JohnDSutter/Analog-Power-Meter-Rev-1/pics/pcb_assembled.jpg

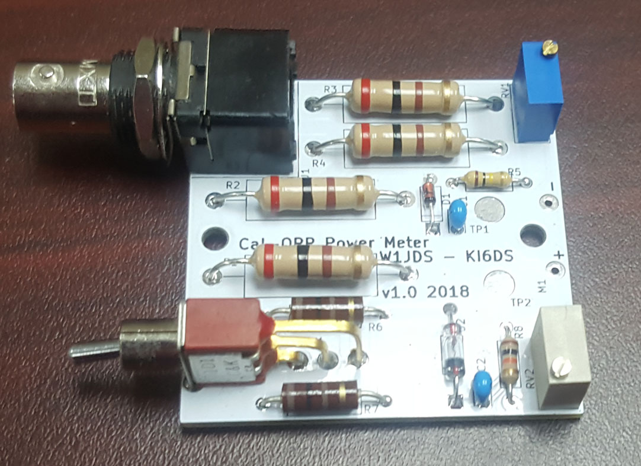
pics/pcb_assembled.jpg
