JohnDSutter/Analog-Power-Meter-Rev-1/pics/20180804_172026.jpg

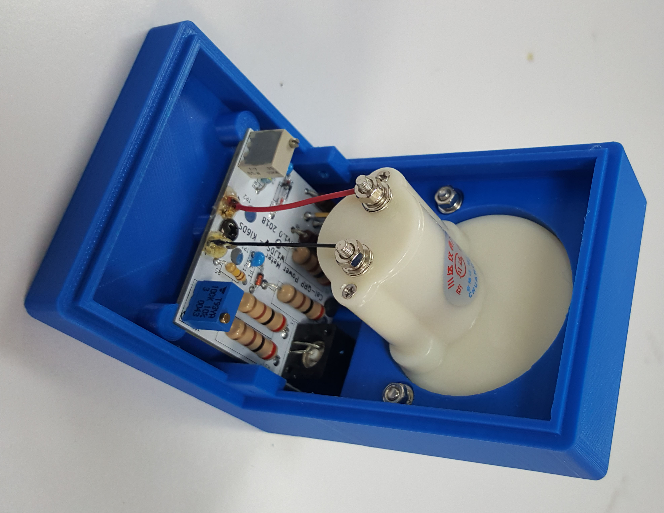
pics/20180804_172026.jpg
