JohnDSutter/Analog-Power-Meter-Rev-1/README.md

# Analog Power Meter Rev 1
 Analog RF Power Meter Designed as a CalQRP Club Project
