JohnDSutter/Analog-Power-Meter-Rev-1/meter face/scan_0064.pdf

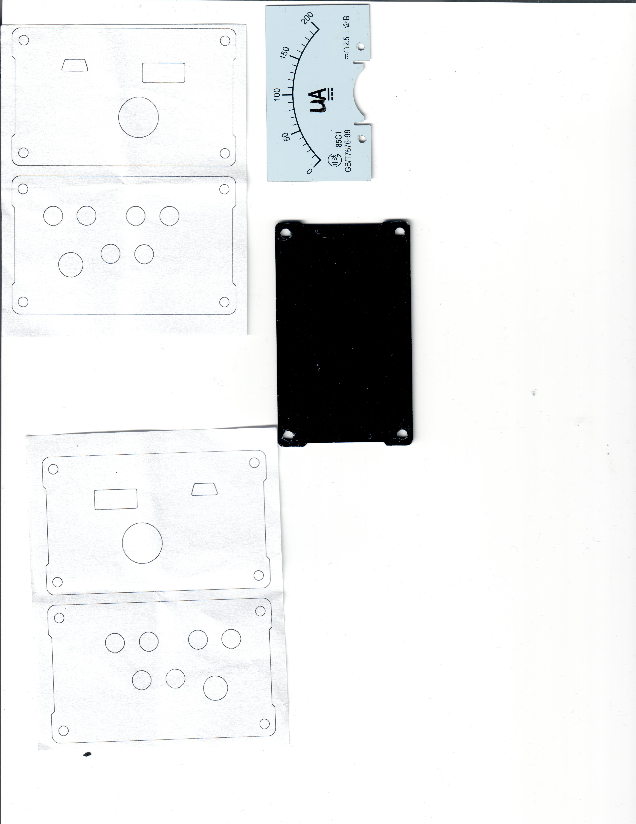
[picture p3: page 1]
