JohnDSutter/Analog-Power-Meter-Rev-1/Case/meter/001.JPG

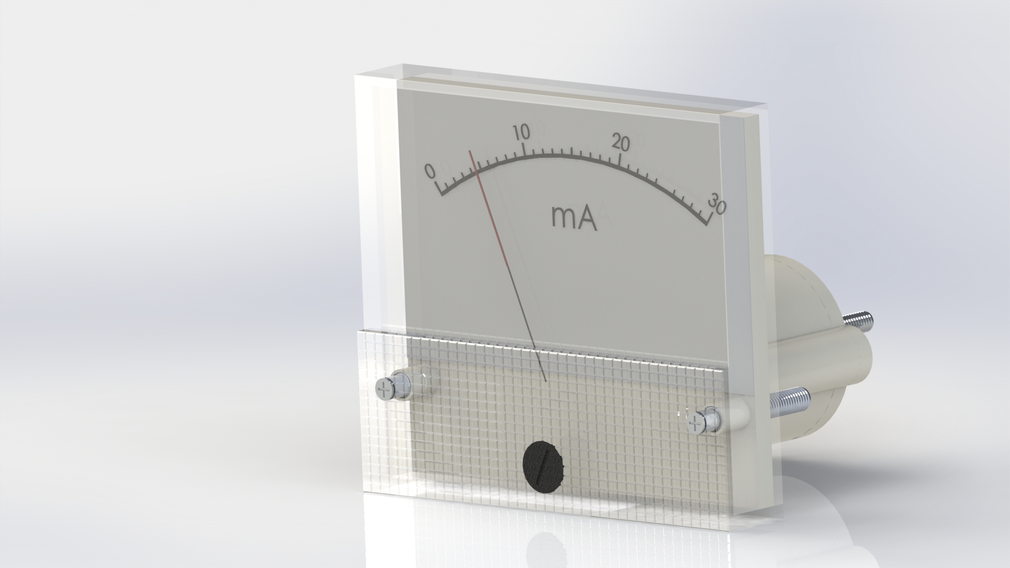
Case/meter/001.JPG
