JohnDSutter/Analog-Power-Meter-Rev-1/Case/meter/002.JPG

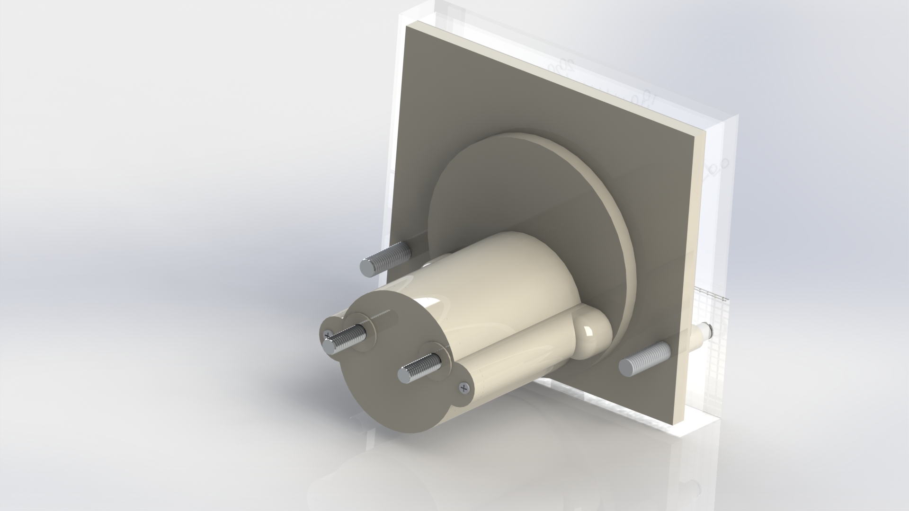
Case/meter/002.JPG
