JohnDSutter/Analog-Power-Meter-Rev-1/Case/meter/003.JPG

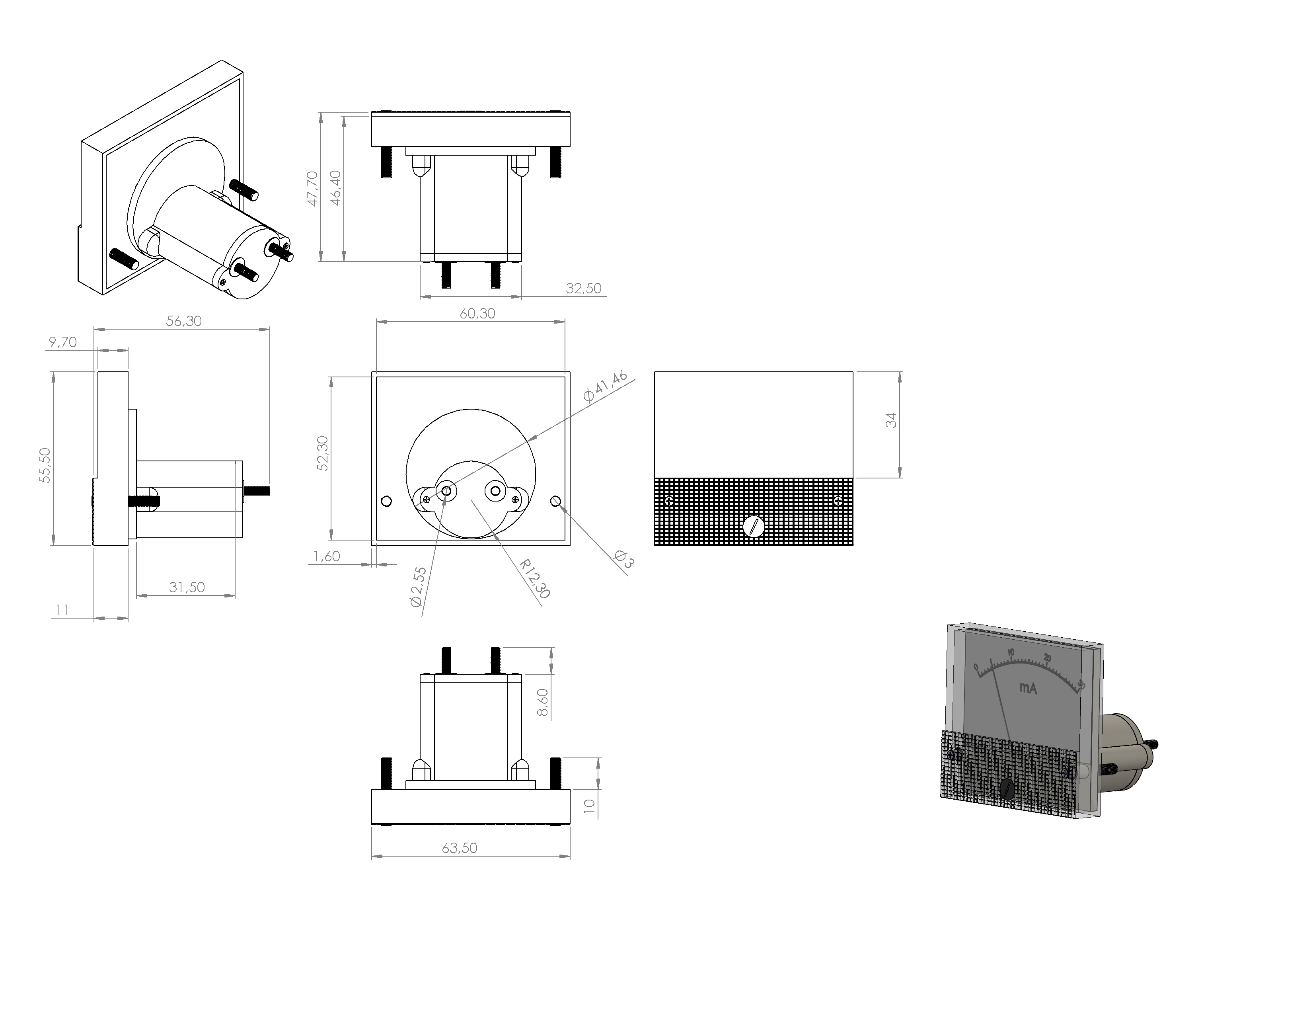
Case/meter/003.JPG
