JohnDSutter/Analog-Power-Meter-Rev-1/meter face/original_face.bmp

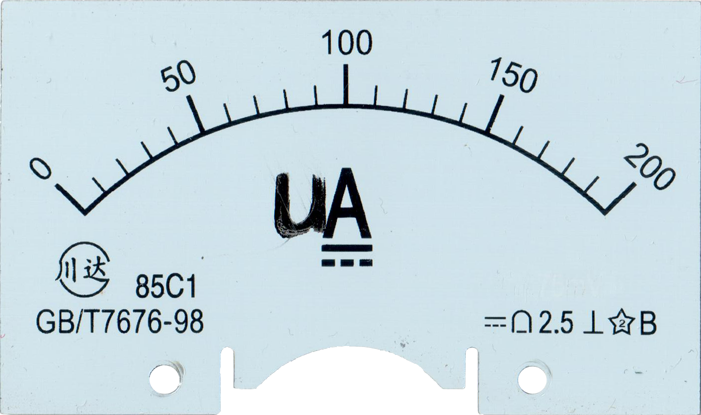
meter face/original_face.bmp
