JohnDSutter/Analog-Power-Meter-Rev-1/meter face/original_face.png

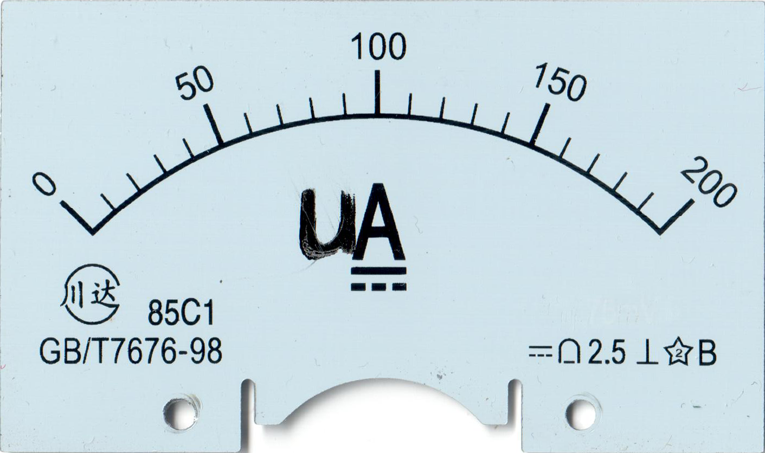
meter face/original_face.png
