JohnDSutter/Analog-Power-Meter-Rev-1/pics/20180722_165023_001.jpg

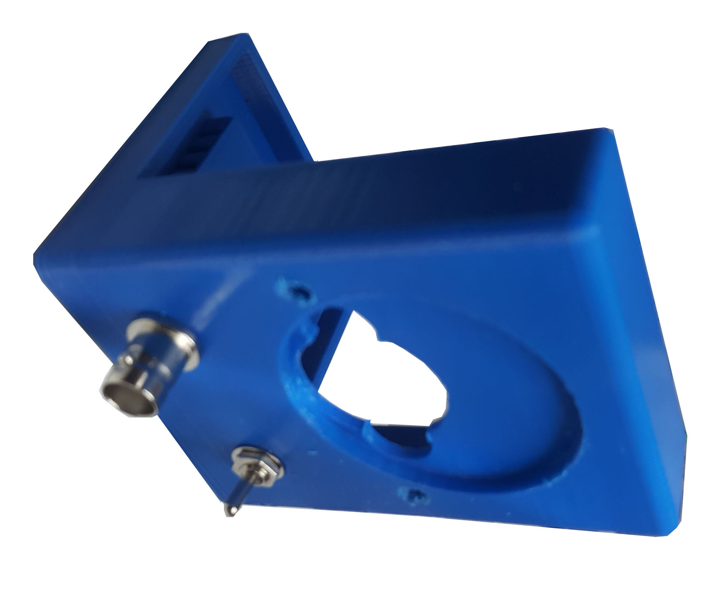
pics/20180722_165023_001.jpg
