JohnDSutter/Analog-Power-Meter-Rev-1/pics/20180722_165047.jpg

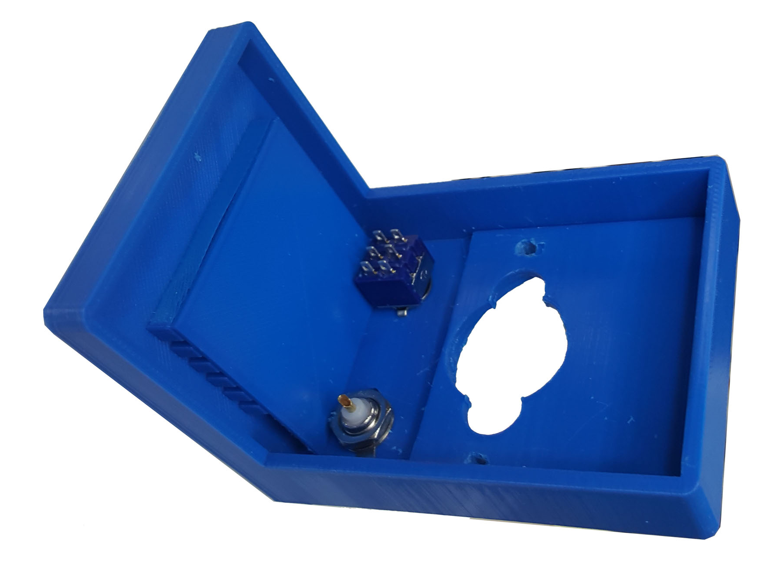
pics/20180722_165047.jpg
