JohnDSutter/Analog-Power-Meter-Rev-1/pics/20180722_170052.jpg

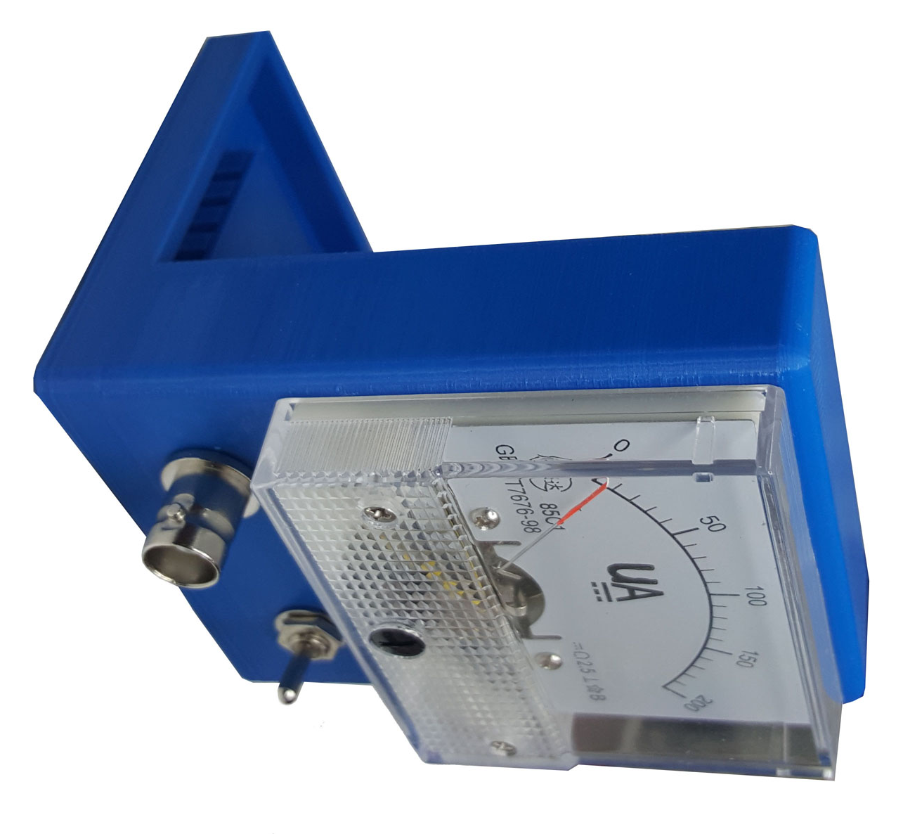
pics/20180722_170052.jpg
