JohnDSutter/Analog-Power-Meter-Rev-1/pics/20180722_170101.jpg

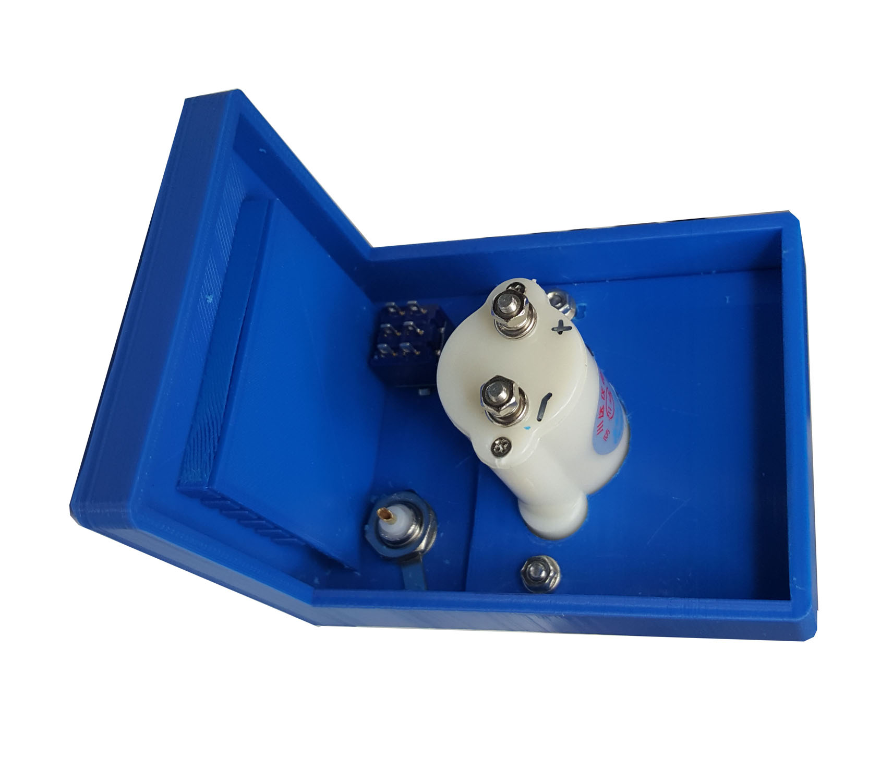
pics/20180722_170101.jpg
