JohnDSutter/Analog-Power-Meter-Rev-1/pics/20180724_211831.jpg

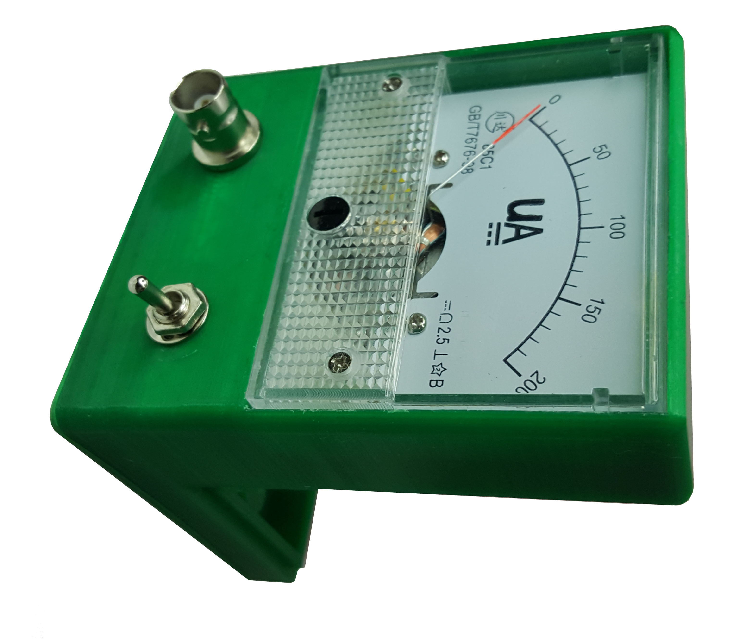
pics/20180724_211831.jpg
