JohnDSutter/Analog-Power-Meter-Rev-1/pics/20180724_211840.jpg

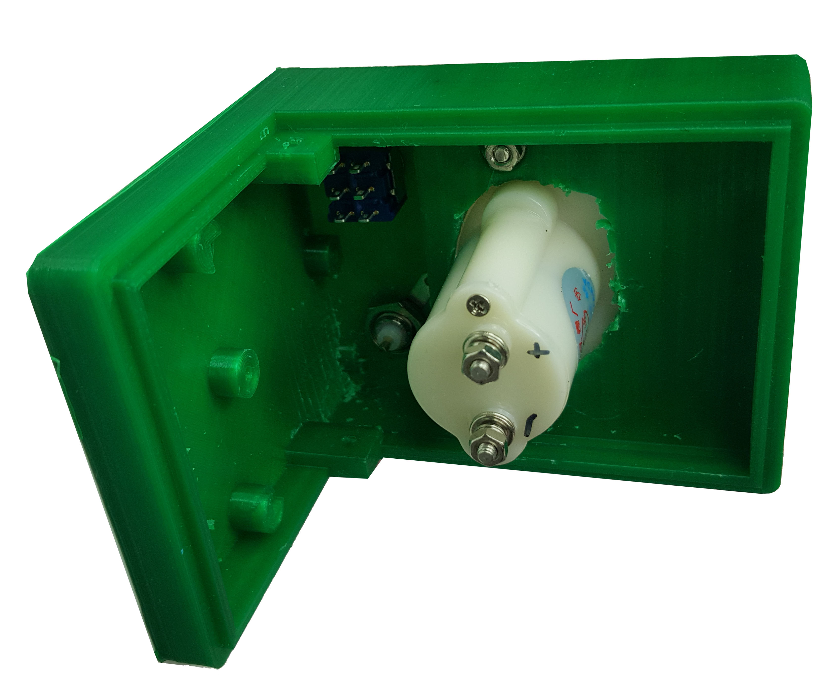
pics/20180724_211840.jpg
