JohnDSutter/Analog-Power-Meter-Rev-1/pics/20180726_223844.jpg

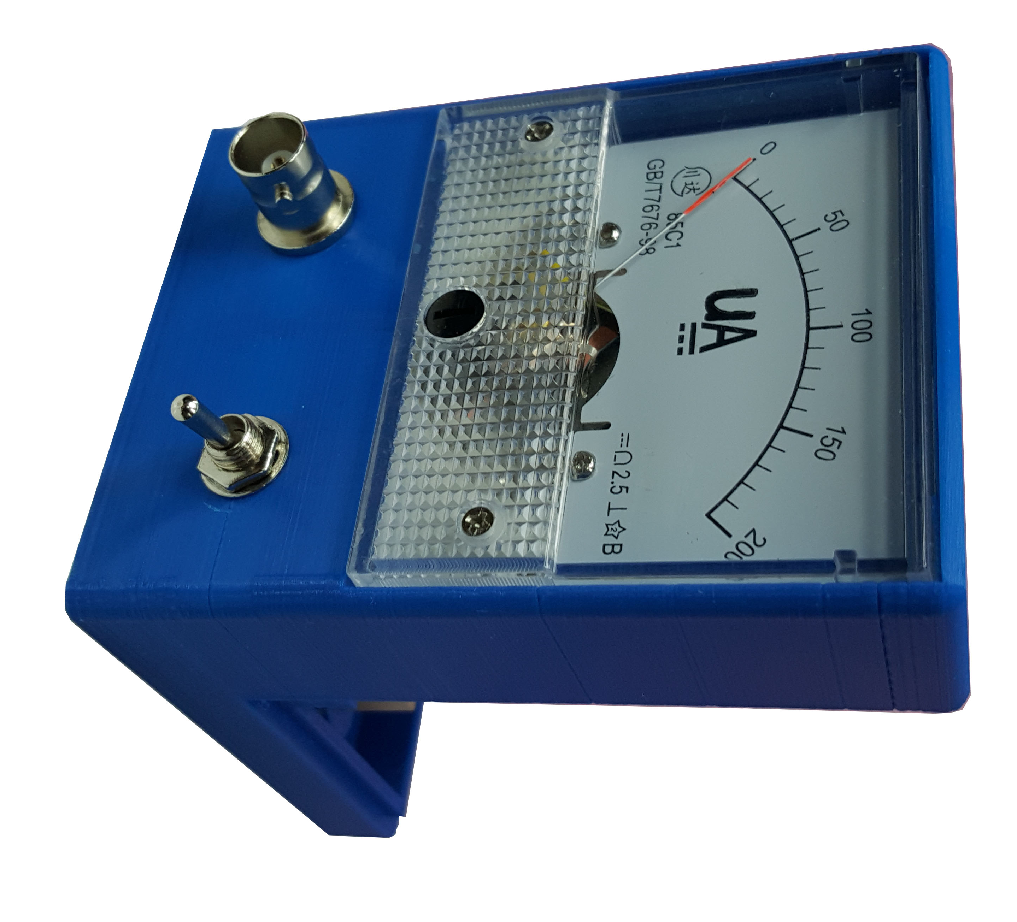
pics/20180726_223844.jpg
