JohnDSutter/Analog-Power-Meter-Rev-1/pics/20180728_095241.jpg

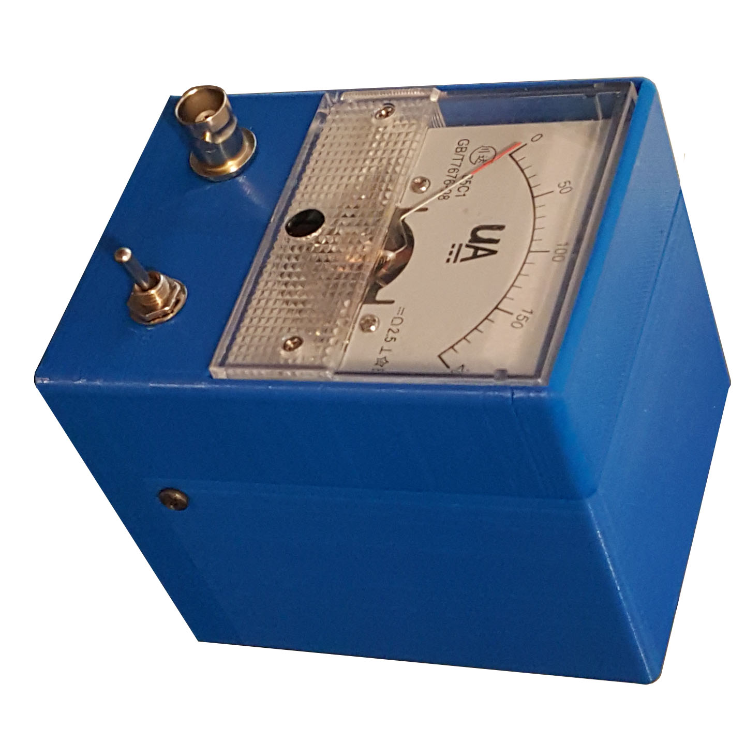
pics/20180728_095241.jpg
