JohnDSutter/Analog-Power-Meter-Rev-1/pics/20180730_180440.jpg

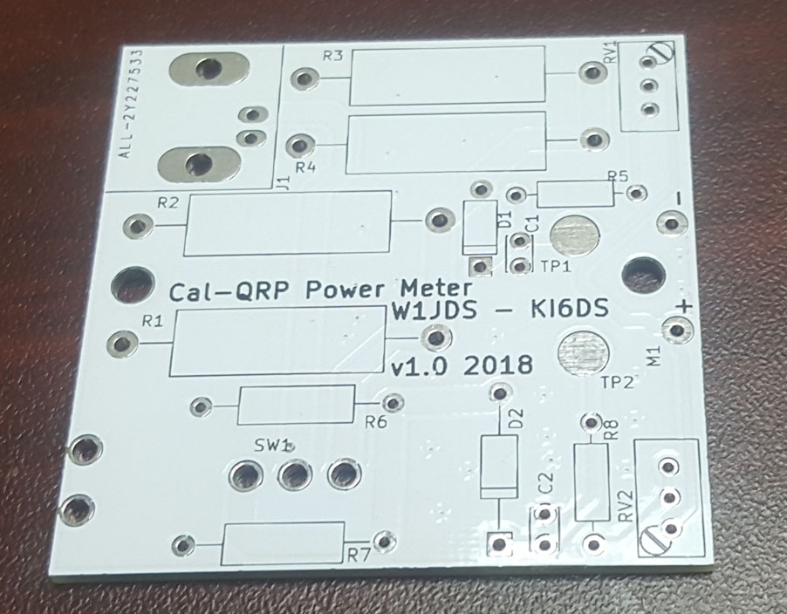
pics/20180730_180440.jpg
