JohnDSutter/Analog-Power-Meter-Rev-1/pics/20180802_153652.jpg

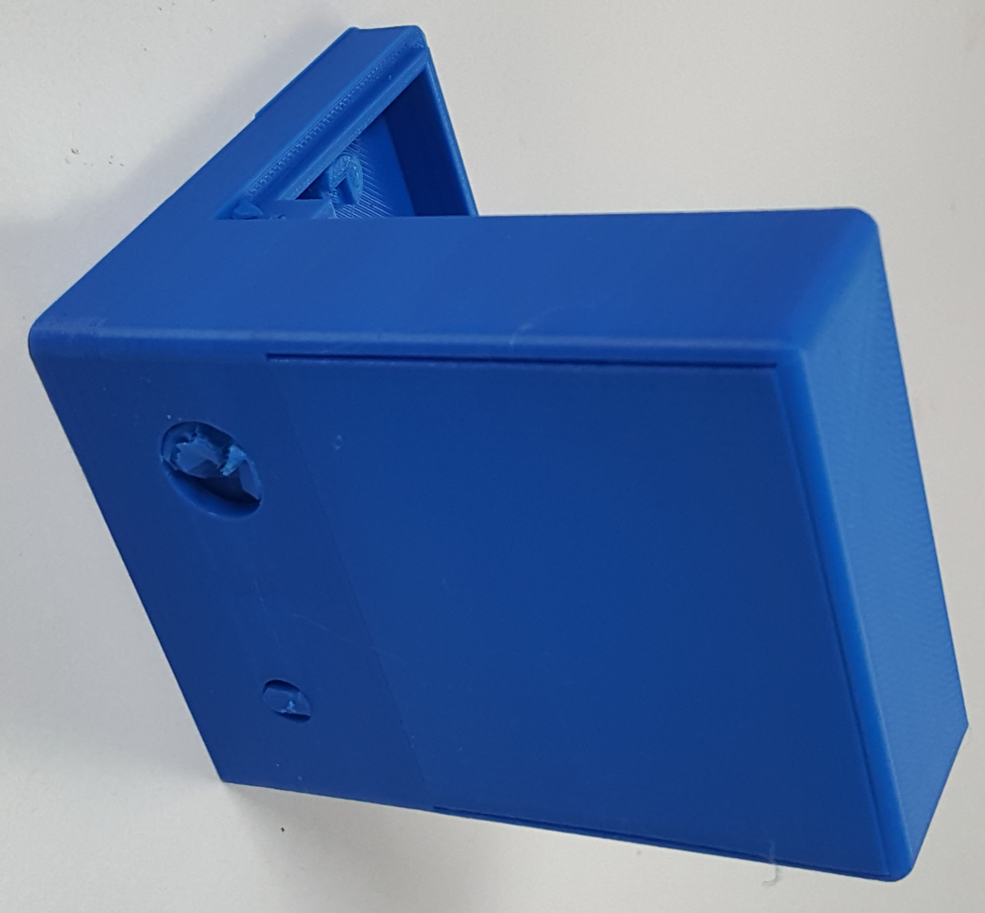
pics/20180802_153652.jpg
