JohnDSutter/Analog-Power-Meter-Rev-1/pics/20180802_162410.jpg

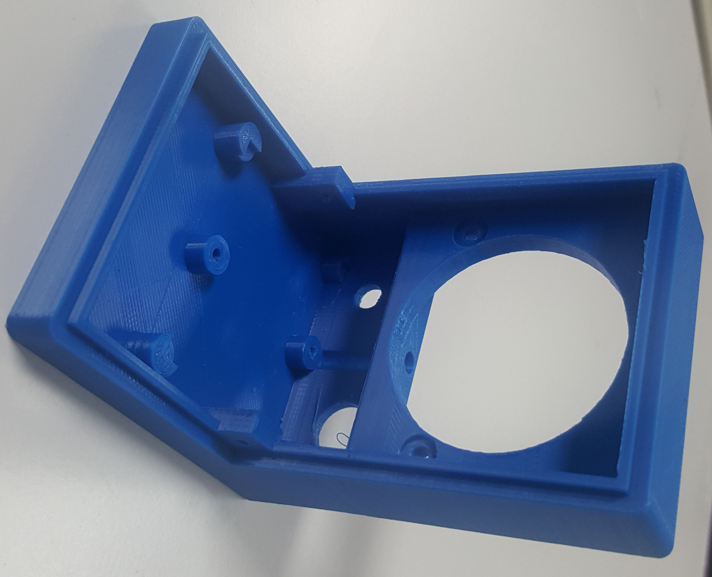
pics/20180802_162410.jpg
