JohnDSutter/Analog-Power-Meter-Rev-1/pics/20180802_162456.jpg

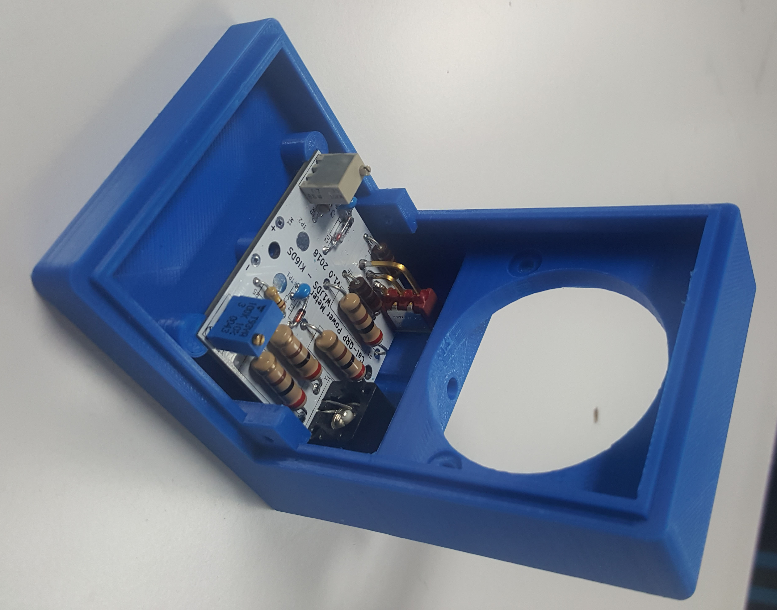
pics/20180802_162456.jpg
