JohnDSutter/Analog-Power-Meter-Rev-1/pics/20180803_123322.jpg

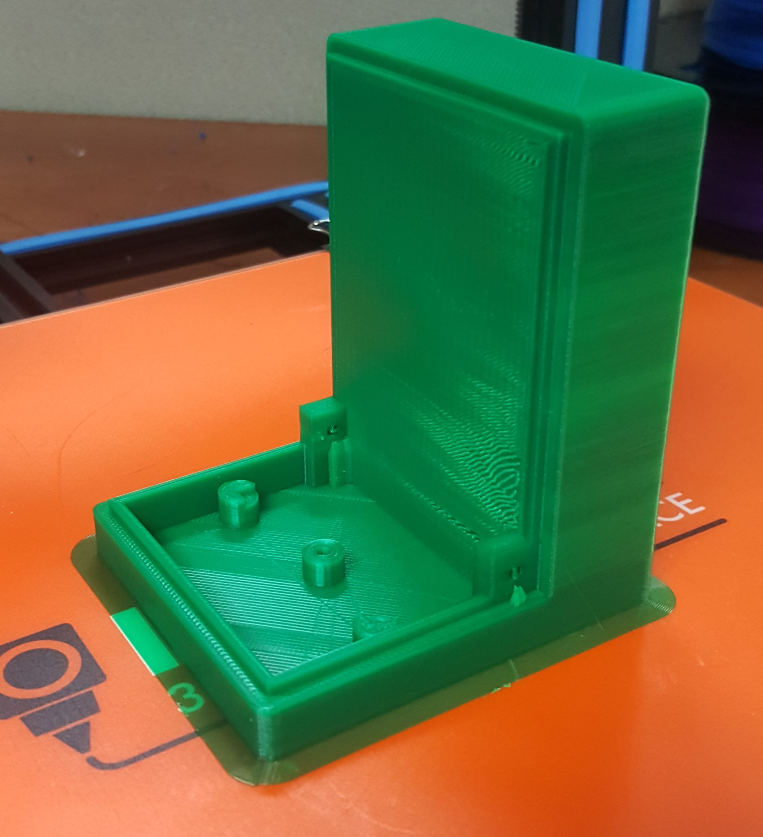
pics/20180803_123322.jpg
