JohnDSutter/Analog-Power-Meter-Rev-1/pics/20180804_170303.jpg

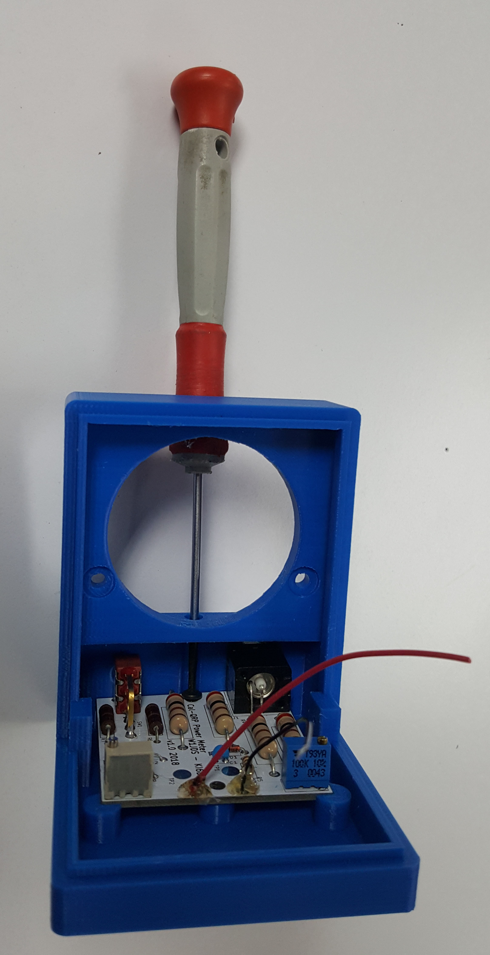
pics/20180804_170303.jpg
