JohnDSutter/Analog-Power-Meter-Rev-1/pics/base_meter_mount.png

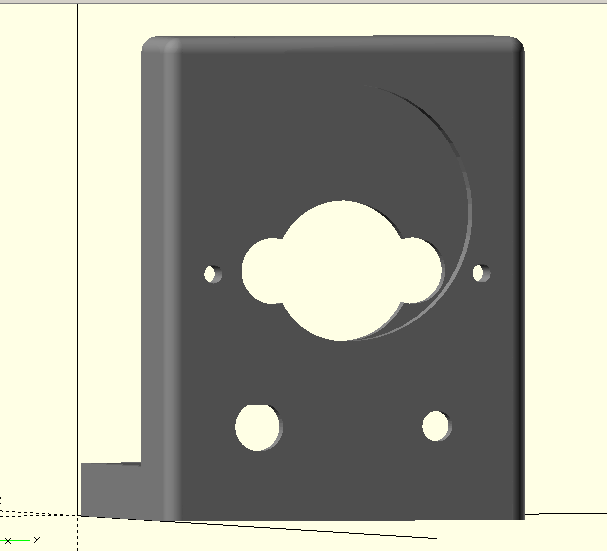
pics/base_meter_mount.png
