JohnDSutter/Analog-Power-Meter-Rev-1/pics/dimensions.png

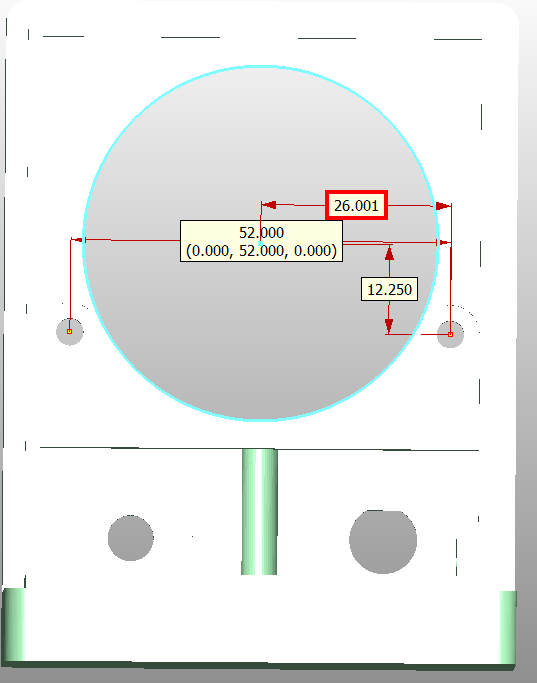
pics/dimensions.png
