JohnDSutter/Analog-Power-Meter-Rev-1/pics/early_enclosure.png

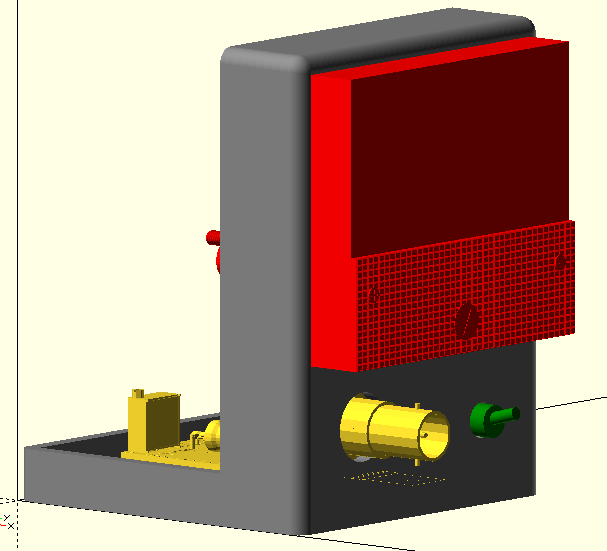
pics/early_enclosure.png
