JohnDSutter/Analog-Power-Meter-Rev-1/pics/floorplan.bmp

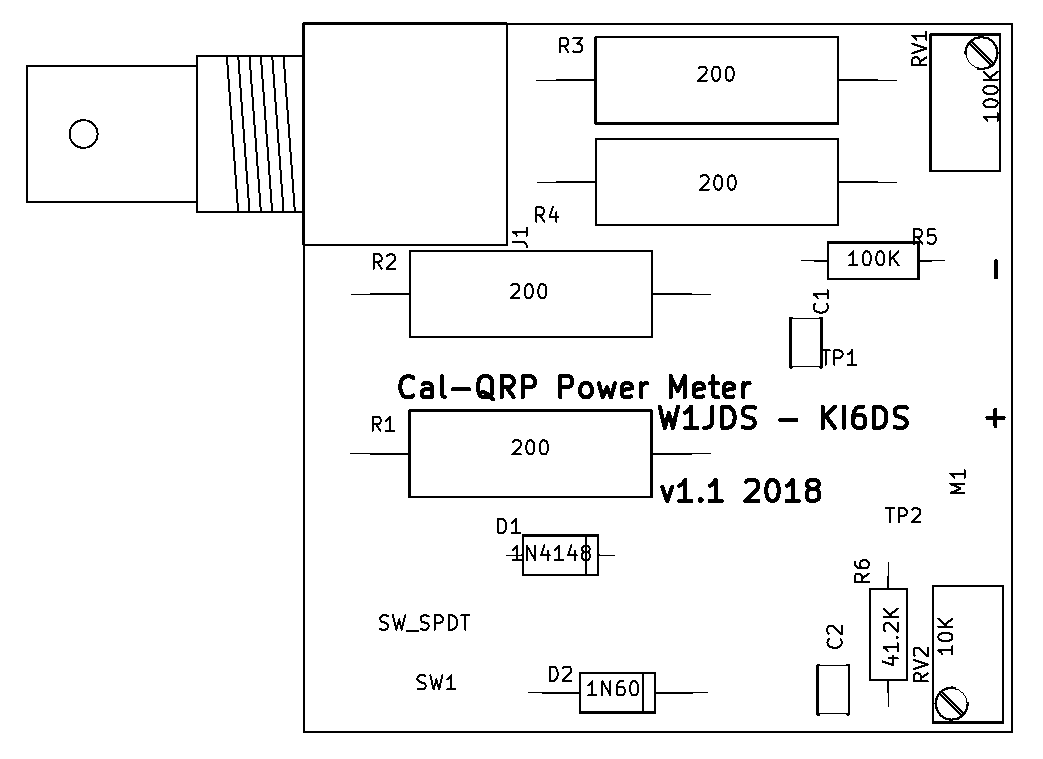
pics/floorplan.bmp
