JohnDSutter/Analog-Power-Meter-Rev-1/pics/layout.bmp

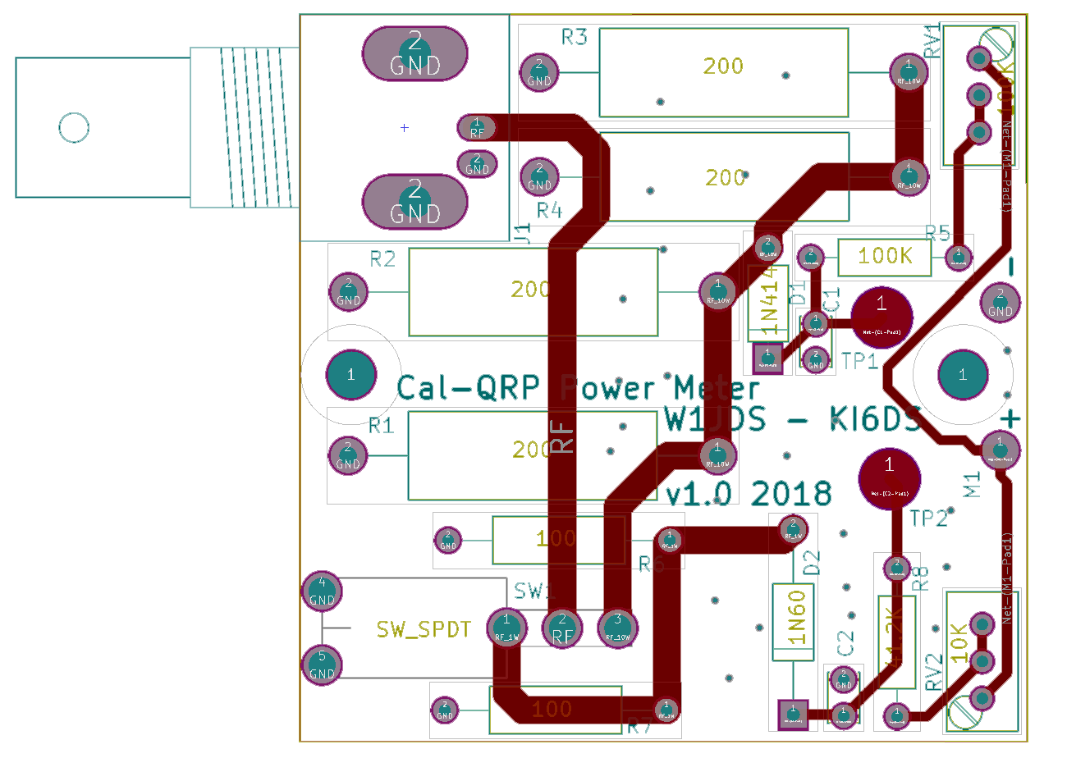
pics/layout.bmp
