JohnDSutter/Analog-Power-Meter-Rev-1/pics/meter_face.bmp

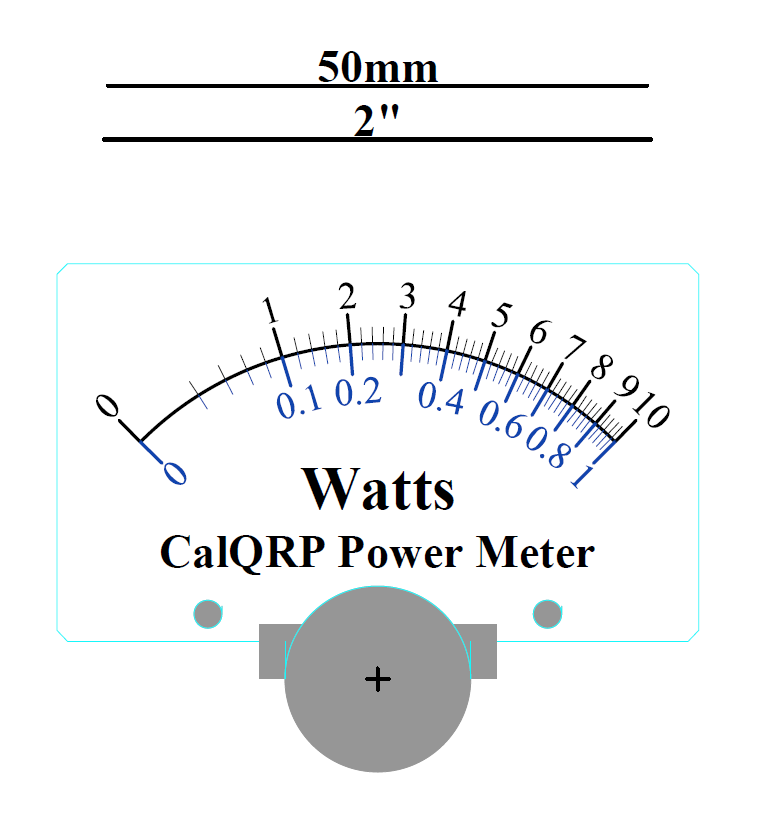
pics/meter_face.bmp
