JohnDSutter/Analog-Power-Meter-Rev-1/pics/pcb.jpg

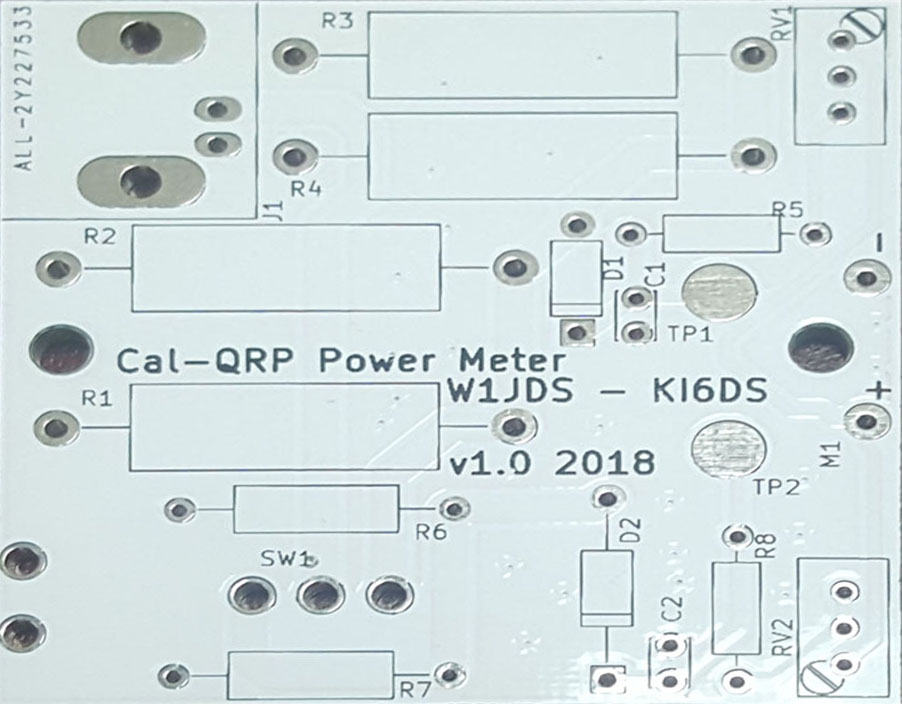
pics/pcb.jpg
