JohnDSutter/Analog-Power-Meter-Rev-1/pics/pcb_3d_view.bmp

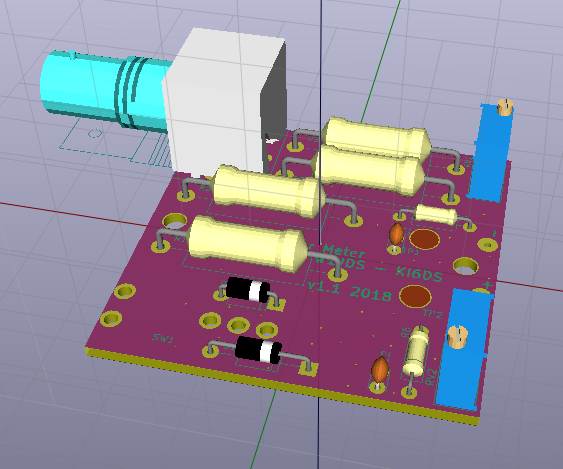
pics/pcb_3d_view.bmp
