JohnDSutter/Analog-Power-Meter-Rev-1/pics/pcb_3d_view.jpg

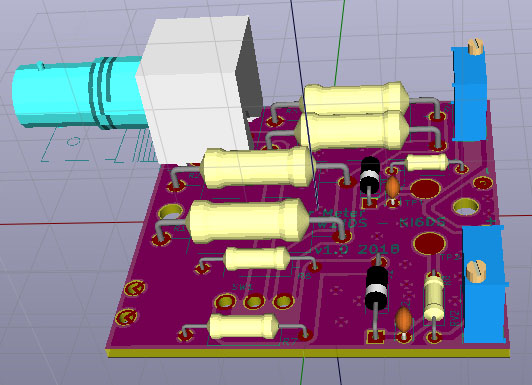
pics/pcb_3d_view.jpg
