JohnDSutter/Analog-Power-Meter-Rev-1/pics/schematic.bmp

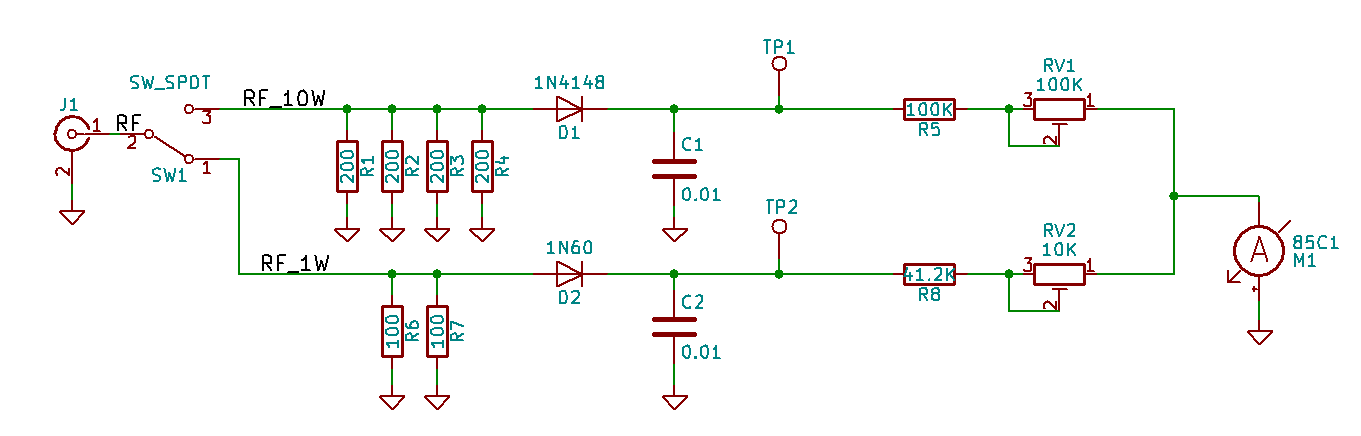
pics/schematic.bmp
