JohnDSutter/Analog-Power-Meter-Rev-1/pics/VNA/20180731_182519.jpg

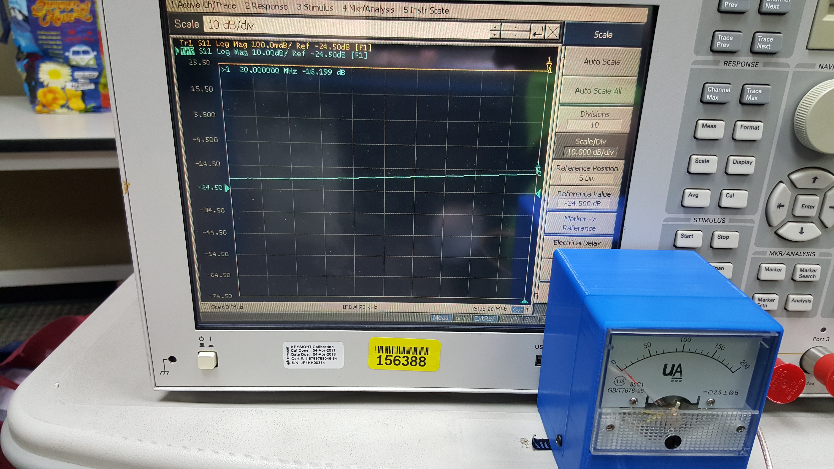
pics/VNA/20180731_182519.jpg
