JohnDSutter/Analog-Power-Meter-Rev-1/pics/VNA/20180731_182536.jpg

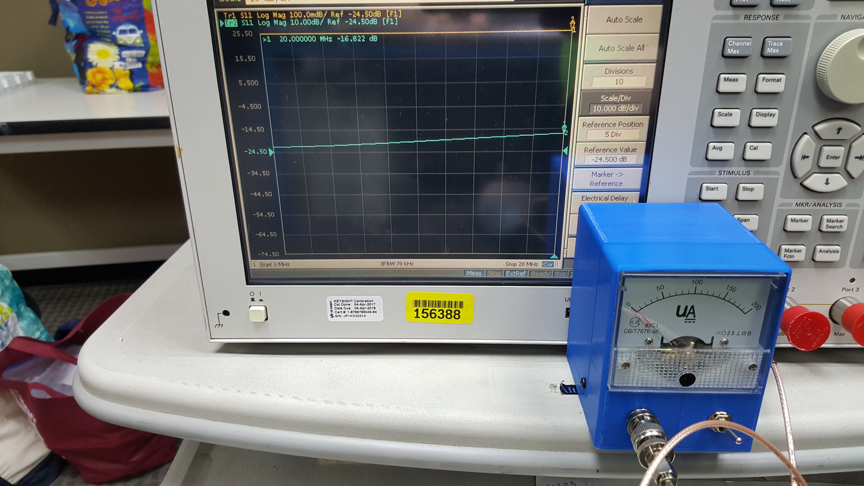
pics/VNA/20180731_182536.jpg
