JohnDSutter/Analog-Power-Meter-Rev-1/pics/VNA/20180731_183011.jpg

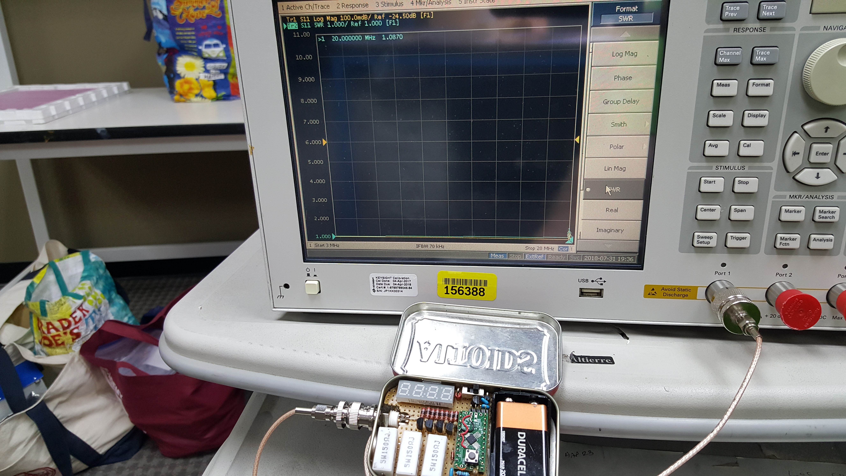
pics/VNA/20180731_183011.jpg
