JohnDSutter/Analog-Power-Meter-Rev-1/pics/VNA/20180731_183559.jpg

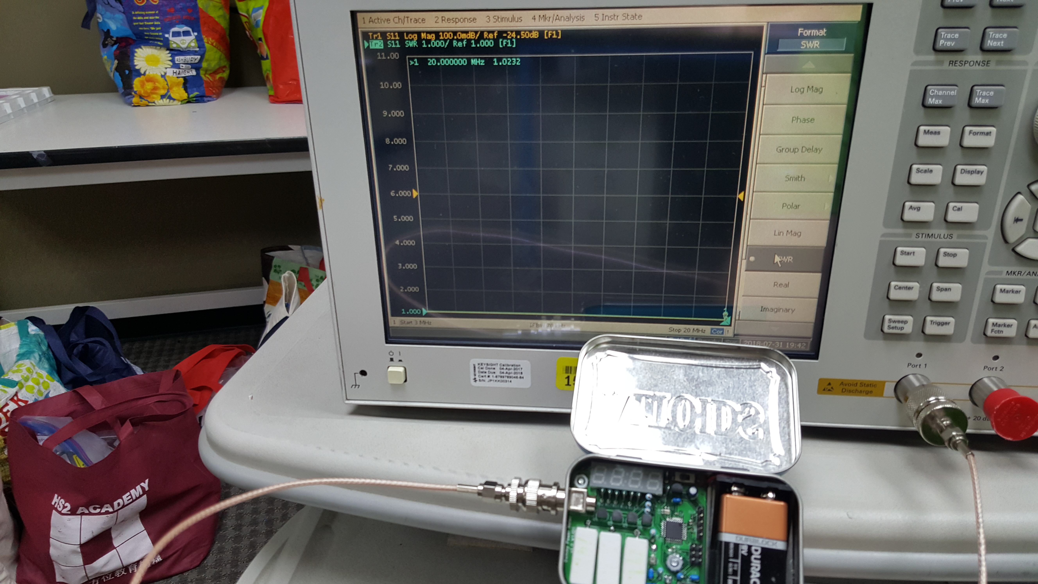
pics/VNA/20180731_183559.jpg
