JohnDSutter/Analog-Power-Meter-Rev-1/pics/VNA/SWR_analog_pm_perf_high.jpg

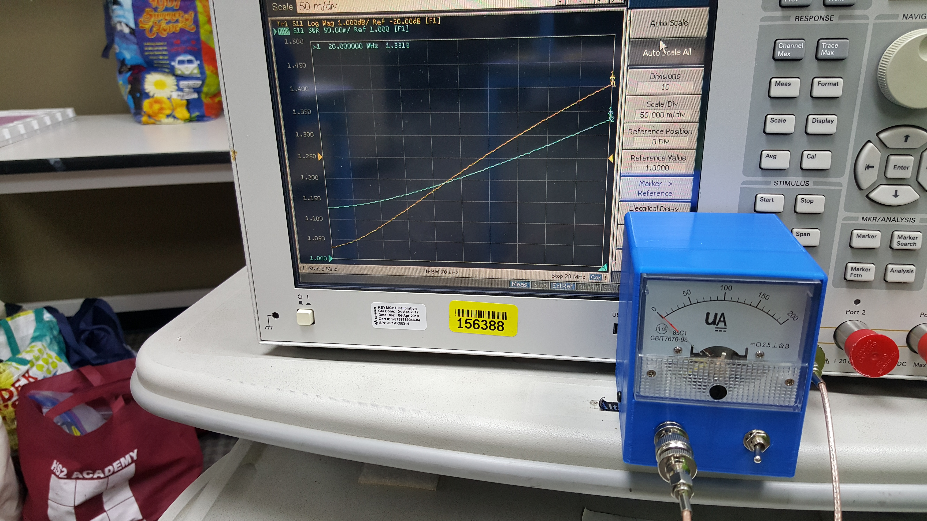
pics/VNA/SWR_analog_pm_perf_high.jpg
