JohnDSutter/Analog-Power-Meter-Rev-1/pics/VNA/SWR_digital_pm_pcb_off.jpg

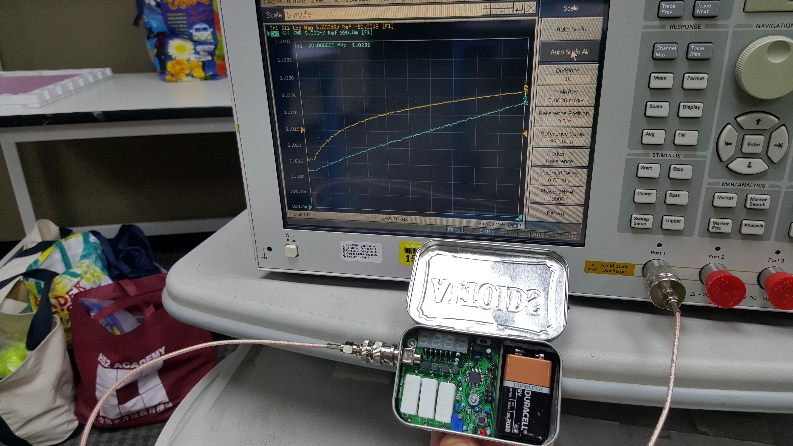
pics/VNA/SWR_digital_pm_pcb_off.jpg
