JohnDSutter/Analog-Power-Meter-Rev-1/pics/VNA/SWR_digital_pm_perf_on.jpg

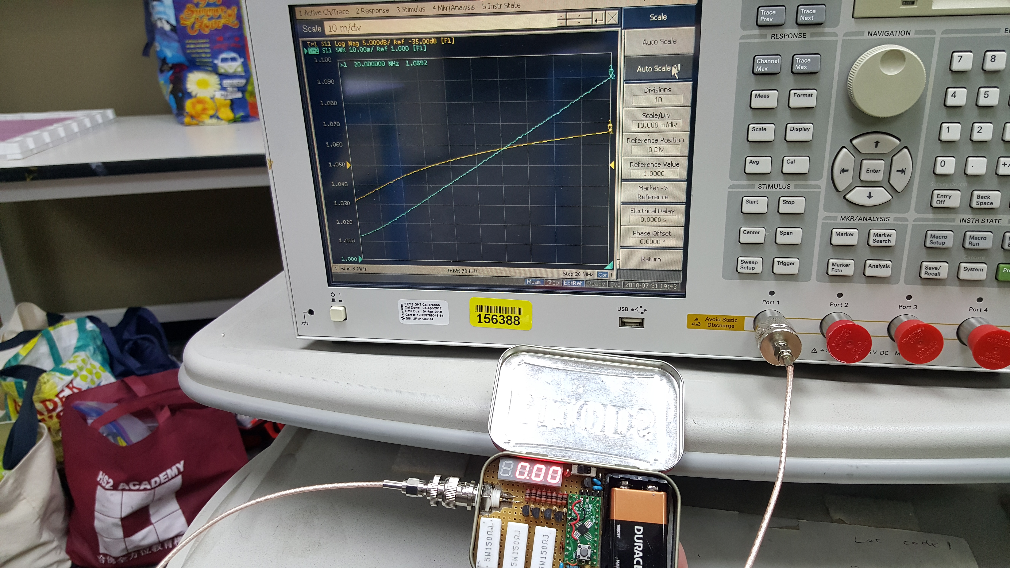
pics/VNA/SWR_digital_pm_perf_on.jpg
