JohnDSutter/Analog-Power-Meter-Rev-1/Component Values.xlsx

Sheet: Sheet1
Reference | Component | Value/PN | Rating
C1, C2 | Ceramic Capacitor | 0.01 | 50 V
D1 | Diode, Silicon | 1N4148
D2 | Diode, Germanium | 1N60
J1 | BNC Connector | Through-hole or panel mount
M1 | Meter | 85C1 | 200 uA
RV1 | Trim pot | 100 K
RV2 | Trim pot | 10 K
R1-R4 | Metal film Resistor | 200 | 3 W
R5 | Metal film Resistor | 100 K | 1/4 W
R6, R7 | Metal film Resistor | 100 | 1/2 W
R8 | Metal film Resistor | 41.2 K | 1/4 W
SW1 | SPDT Switch | C&K 7101MD9AV2BE or panel mount

Sheet: Sheet2
Power Max | Rfixed | Rvariable | V | Imin | %scale | Imax | %scale
10 | 100000 | 100000 | 21.66067977 | 0.0001083033989 | 54.15169944% | 0.0002166067977 | 108.3033989%
4.5 | 100000 | 100000 | 14.8 | 7.4e-05 | 37% | 0.000148 | 74%
1 | 10000 | 10000 | 6.871067812 | 0.0003435533906 | 171.7766953% | 0.0006871067812 | 343.5533906%
3.42 | 100000 | 100000 | 12.49324201 | 6.246621004e-05 | 31.23310502% | 0.0001249324201 | 62.46621004%
Vdrop1 | 0.7
Vdrop2 | 0.2
Meter | 0.0002
