JohnDSutter/Analog-Power-Meter-Rev-1/Case/meter/Assem3.SLDASM

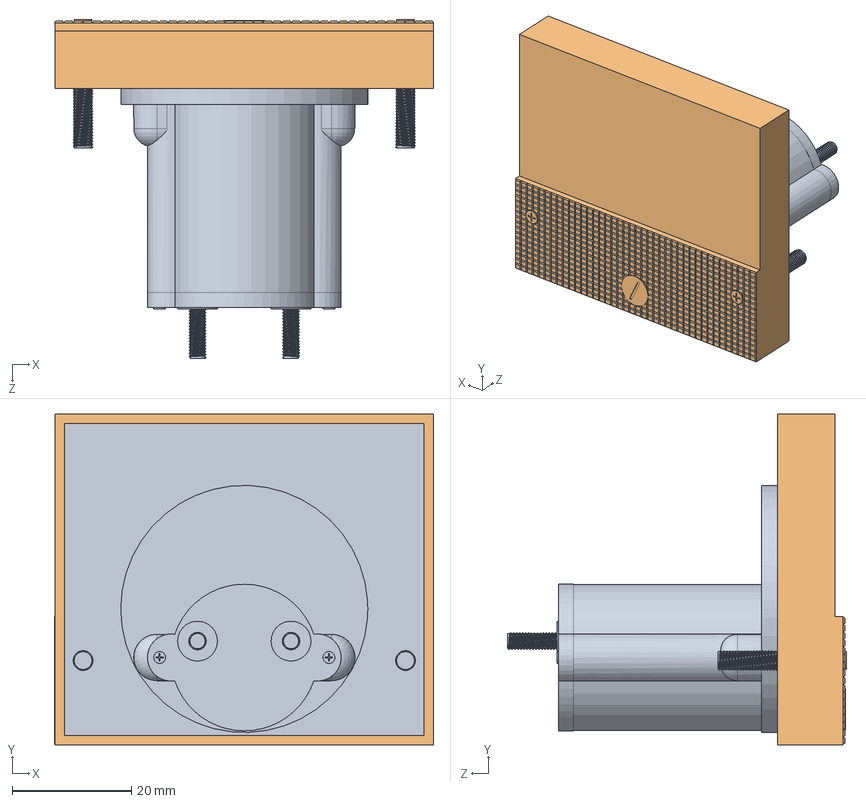
[picture p54: CAD file, 2021-12-27]
Case/meter/Assem3.SLDASM
63.6 x 55.5 x 56.9 mm
Part3^Assem3
Part4^Assem3
