JohnDSutter/Analog-Power-Meter-Rev-1/Case/base_sunk.stl

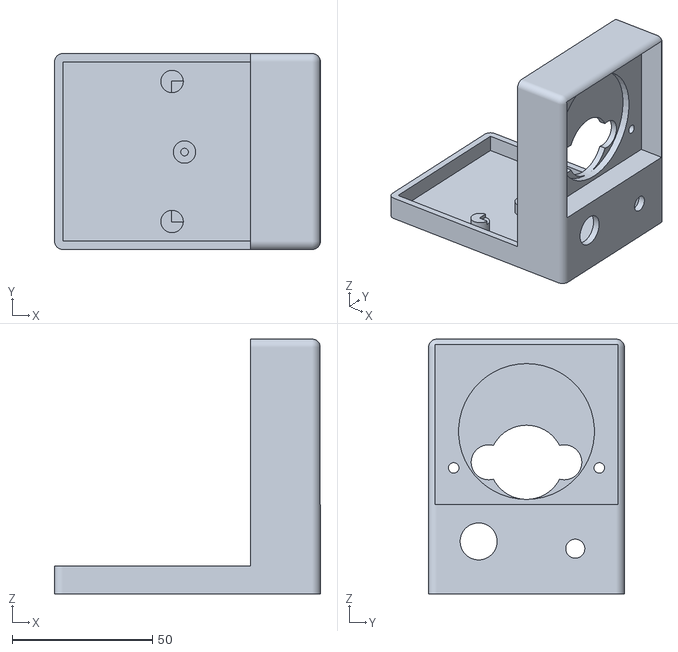
[picture p55: CAD file, 2021-12-27]
Case/base_sunk.stl
95.0 x 70.0 x 91.0
