JohnDSutter/Analog-Power-Meter-Rev-1/shapes3D/Analog Power Meter.stl

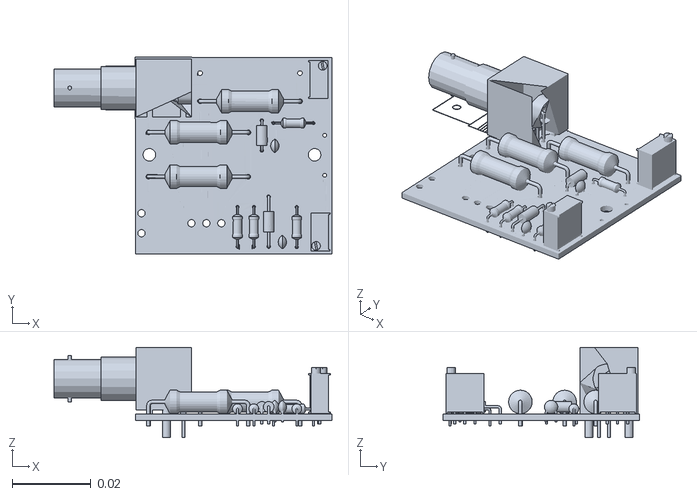
[picture p56: CAD file, 2021-12-27]
shapes3D/Analog Power Meter.stl
0.0707 x 0.0501 x 0.023
