JohnDSutter/Analog-Power-Meter-Rev-1/Case/case_bottom.stl

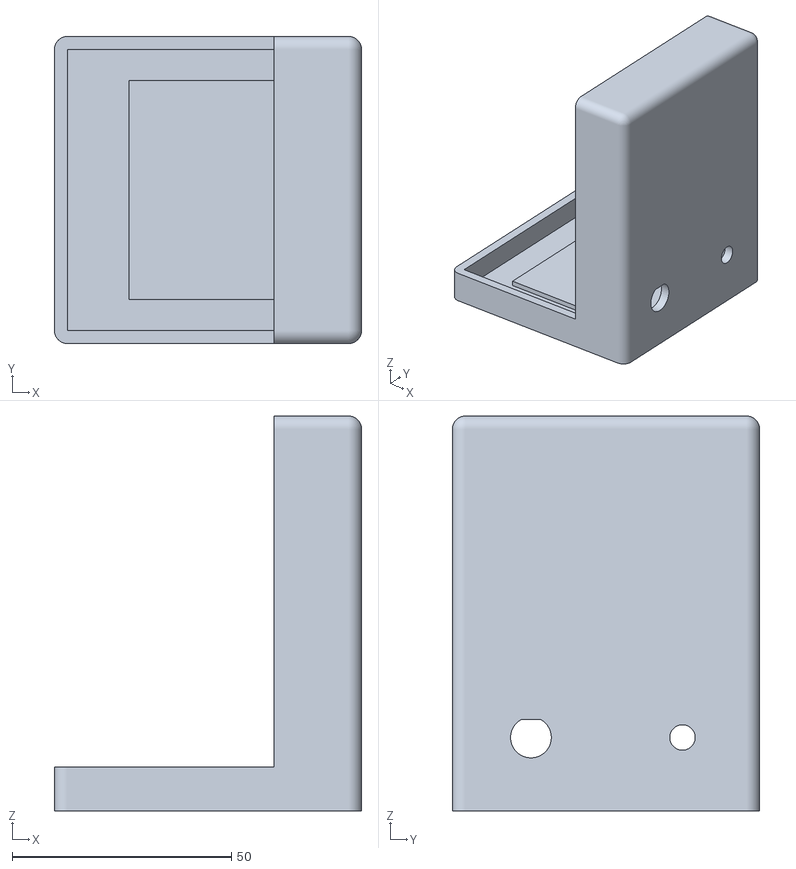
[picture p57: CAD file, 2021-12-27]
Case/case_bottom.stl
70.0 x 70.0 x 90.0
