JohnDSutter/Analog-Power-Meter-Rev-1/Case/meter/part001.SLDPRT

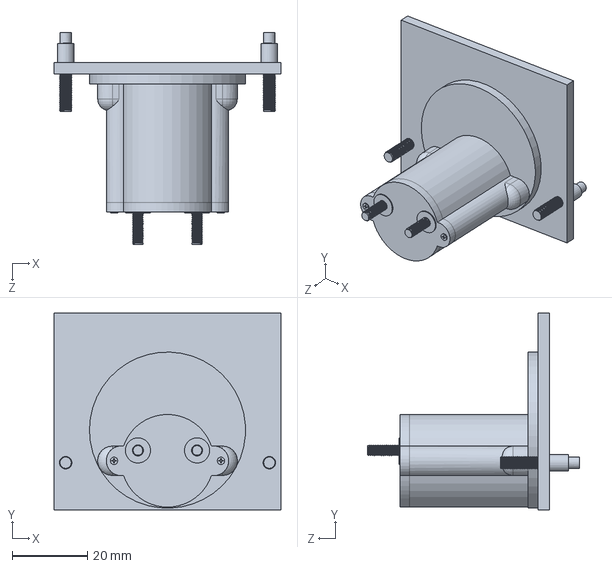
[picture p58: CAD file, 2021-12-27]
Case/meter/part001.SLDPRT
60.3 x 52.3 x 56.3 mm
