JohnDSutter/Analog-Power-Meter-Rev-1/Case/switch/7101MD9AV2BE_fix.stl

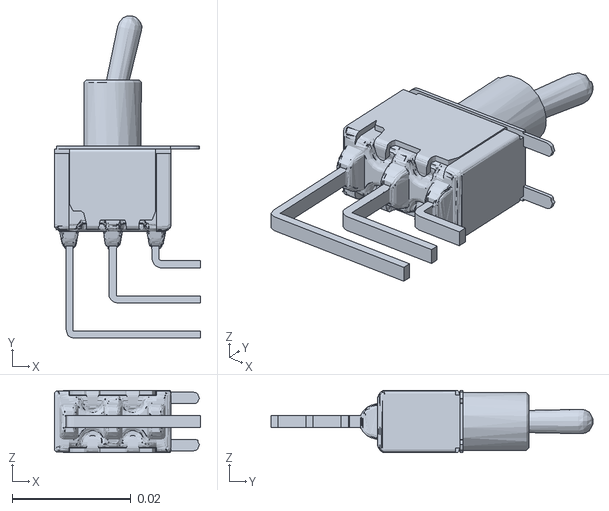
[picture p59: CAD file, 2021-12-27]
Case/switch/7101MD9AV2BE_fix.stl
0.0247 x 0.0543 x 0.0105
