JohnDSutter/Analog-Power-Meter-Rev-1/Case/case_bottom2.stl

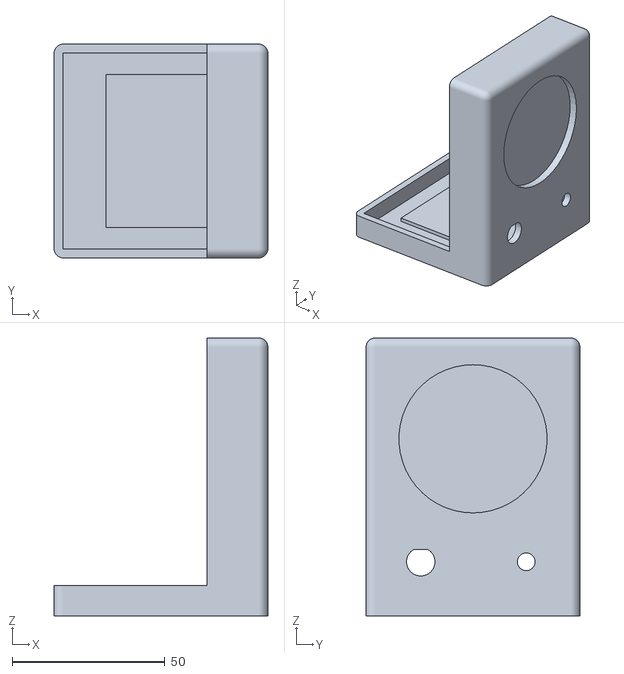
[picture p60: CAD file, 2021-12-27]
Case/case_bottom2.stl
70.0 x 70.0 x 91.0
