JohnDSutter/Analog-Power-Meter-Rev-1/Case/APM_NF.stl

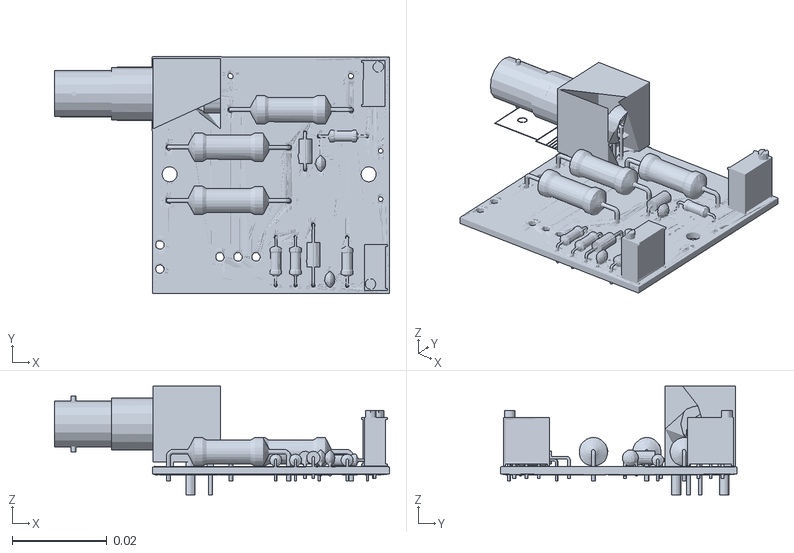
[picture p61: CAD file, 2021-12-27]
Case/APM_NF.stl
0.0707 x 0.0501 x 0.0229
