JohnDSutter/Analog-Power-Meter-Rev-1/Case/top.stl

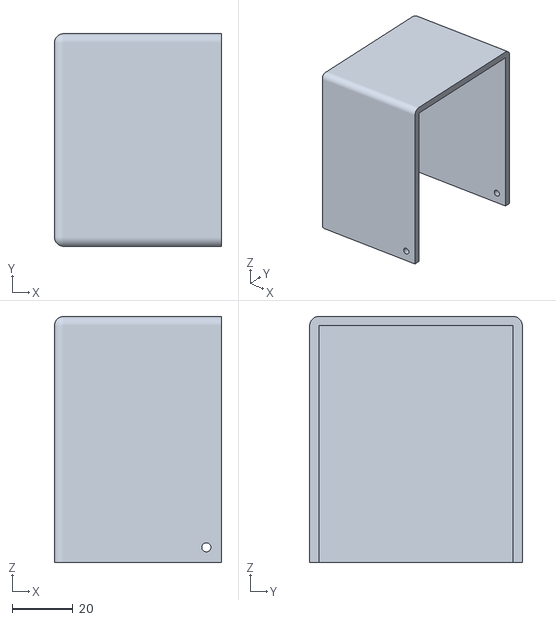
[picture p62: CAD file, 2021-12-27]
Case/top.stl
55.0 x 70.0 x 81.0
