JohnDSutter/Analog-Power-Meter-Rev-1/Case/base_through_hole.stl

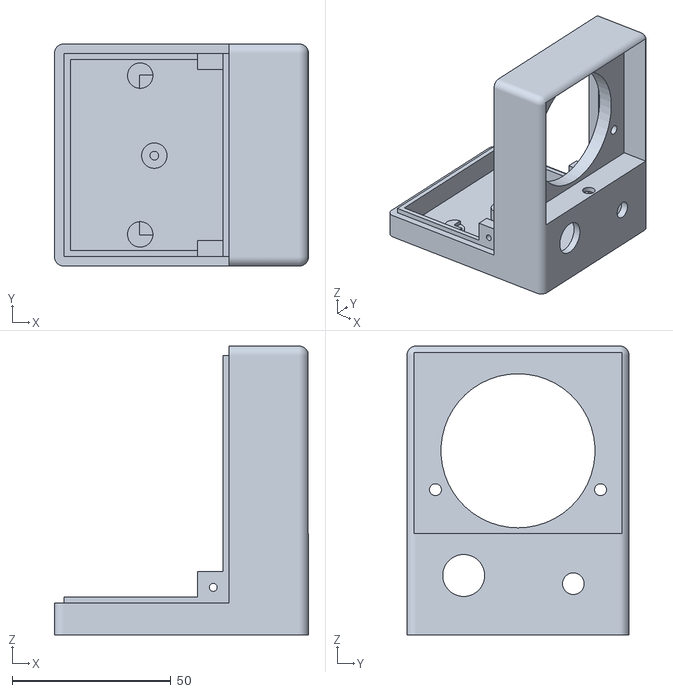
[picture p63: CAD file, 2021-12-27]
Case/base_through_hole.stl
80.0 x 70.0 x 91.0
