JohnDSutter/Analog-Power-Meter-Rev-1/Case/base.stl

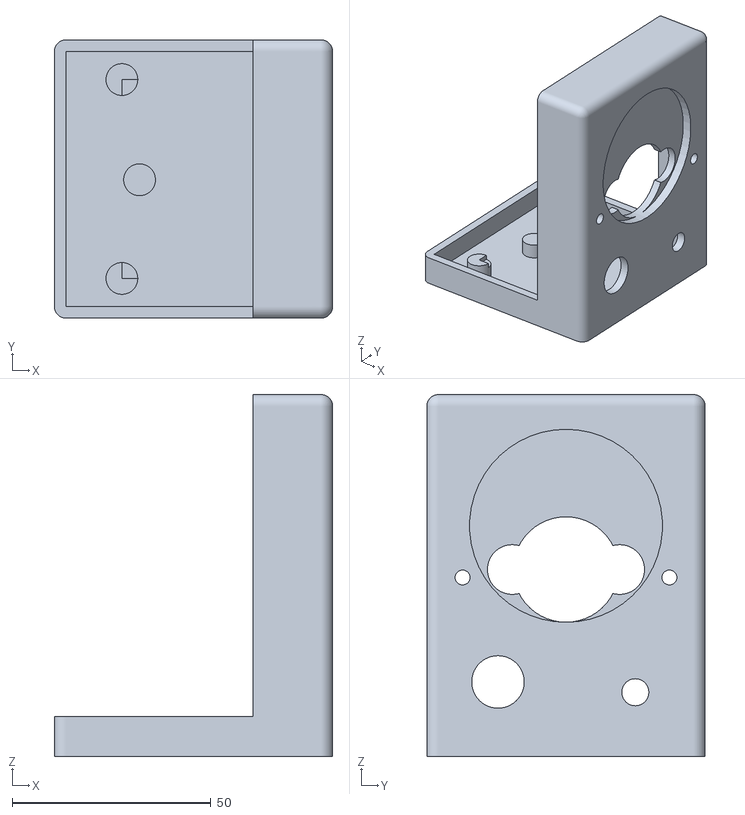
[picture p64: CAD file, 2021-12-27]
Case/base.stl
70.0 x 70.0 x 91.0
