JohnDSutter/Analog-Power-Meter-Rev-1/(list of files, cad)

Other CAD files:
Case/switch/7101MD9AV2BE.sldasm
Case/switch/1_2.sldprt
Case/meter/85c1_meter.stl
Case/85c1_meter.stl
Case/7101MD9AV2BE.stl
Case/switch/7101MD9AV2BE_fix2a.stl
Case/switch/1_4.sldprt
Case/7101MD9AV2BE_fix2.stl
Case/switch/7101MD9AV2BE_fix2.stl
Case/7101MD9AV2BE_fix2a.stl
Case/base_panel_mount.stl
Case/base_sunk_80.stl
Case/7101MD9AV2BE.obj
Case/switch/7101MD9AV2BE.skp
