JohnDSutter/Analog-Power-Meter-Rev-1/meter face/CalQRP Meter Face.pdf

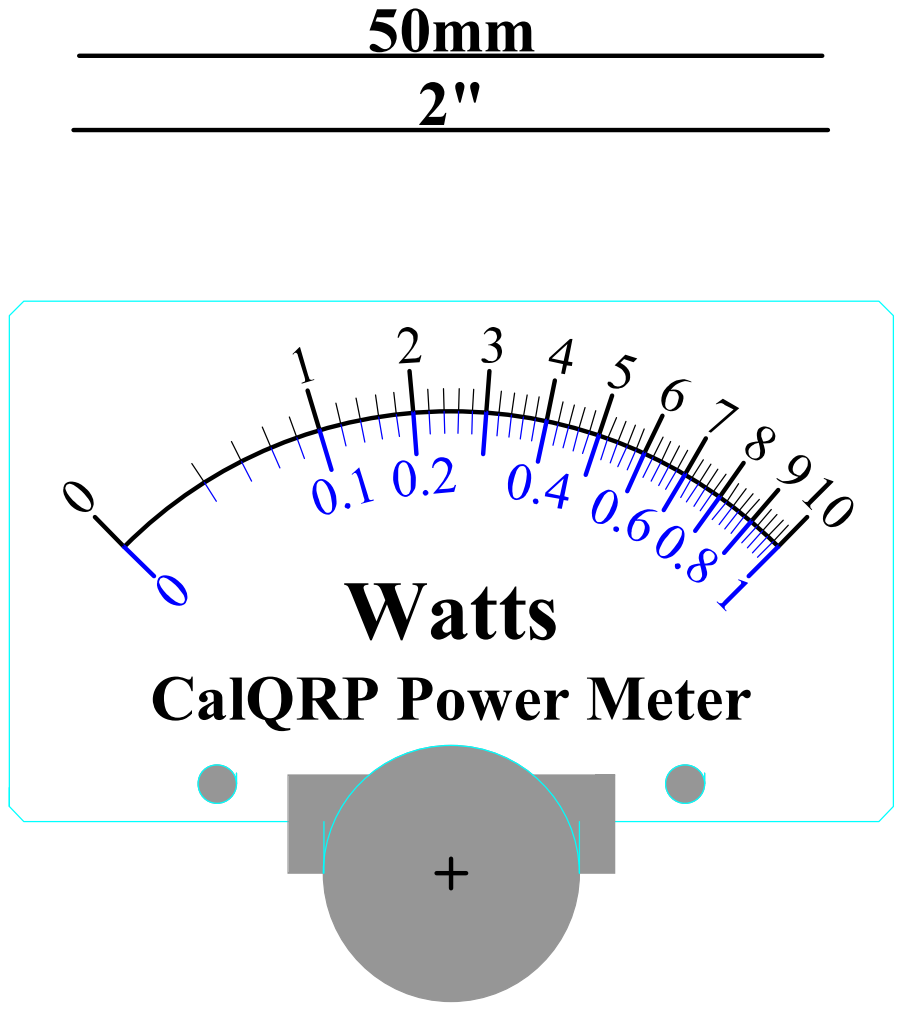
[picture p82: page 1]
Watts

CalQRP Power Meter
