JohnDSutter/Analog-Power-Meter-Rev-1/Analog Power Meter.kicad_pcb

## KiCad design Analog Power Meter.kicad_pcb (2021-12-27)

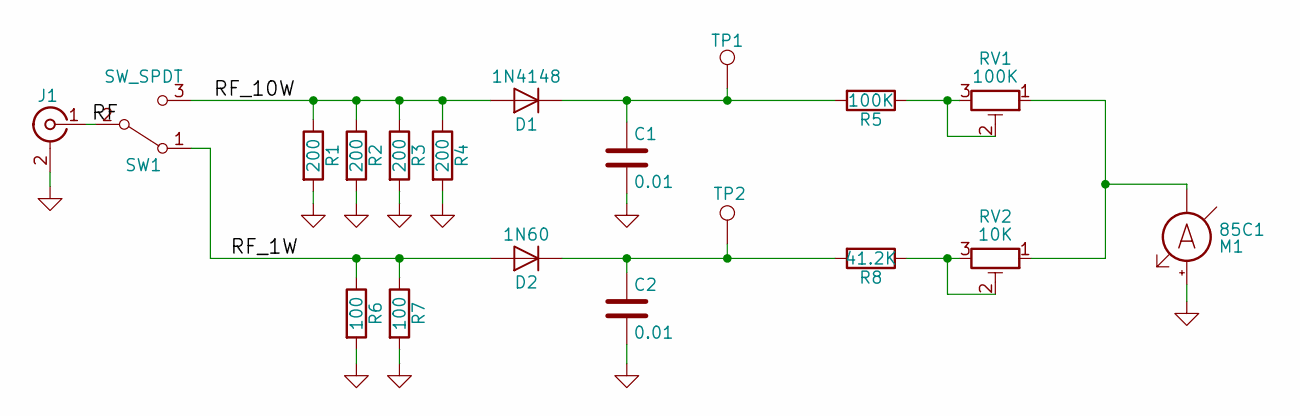
[picture p83: schematic Analog Power Meter.sch]

Parts:
C1, C2: 0.01; C_Disc_D3.4mm_W2.1mm_P2.50mm
D1: 1N4148; D_A-405_P7.62mm_Horizontal
D2: 1N60; D_A-405_P12.70mm_Horizontal
J1: Conn_Coaxial; BNC_Socket_TYCO-AMP_LargePads
M1: 85C1; WireConnection_1.00mmDrill
R1, R2, R3, R4: 200; R_Axial_DIN0617_L17.0mm_D6.0mm_P25.40mm_Horizontal
R5: 100K; R_Axial_DIN0207_L6.3mm_D2.5mm_P10.16mm_Horizontal
R6, R7: 100; R_Axial_DIN0207_L6.3mm_D2.5mm_P10.16mm_Horizontal
R8: 41.2K; R_Axial_DIN0207_L6.3mm_D2.5mm_P10.16mm_Horizontal
RV1: 100K; Potentiometer_Trimmer_Bourns_3296W
RV2: 10K; Potentiometer_Trimmer_Bourns_3296W
SW1: SW_SPDT; SW_CuK_OS102011MA1QN1_SPDT_Angled
TP1, TP2: TEST_1P; SolderWirePad_single_1-5mmDrill

Connections:
/RF: J1.1 (In), SW1.2 (B)
/RF_1W: D2.2 (A), R6.1, R7.1, SW1.1 (A)
/RF_10W: D1.2 (A), R1.1, R2.1, R3.1, R4.1, SW1.3 (C)
GND: C1.2, C2.2, J1.2 (Ext), M1.2 (+), R1.2, R2.2, R3.2, R4.2, R6.2, R7.2, SW1.4, SW1.5
unnamed: C1.1, D1.1 (K), R5.2, TP1.1
unnamed: C2.1, D2.1 (K), R8.2, TP2.1
unnamed: M1.1 (-), RV1.1, RV2.1
unnamed: R5.1, RV1.2, RV1.3
unnamed: R8.1, RV2.2, RV2.3

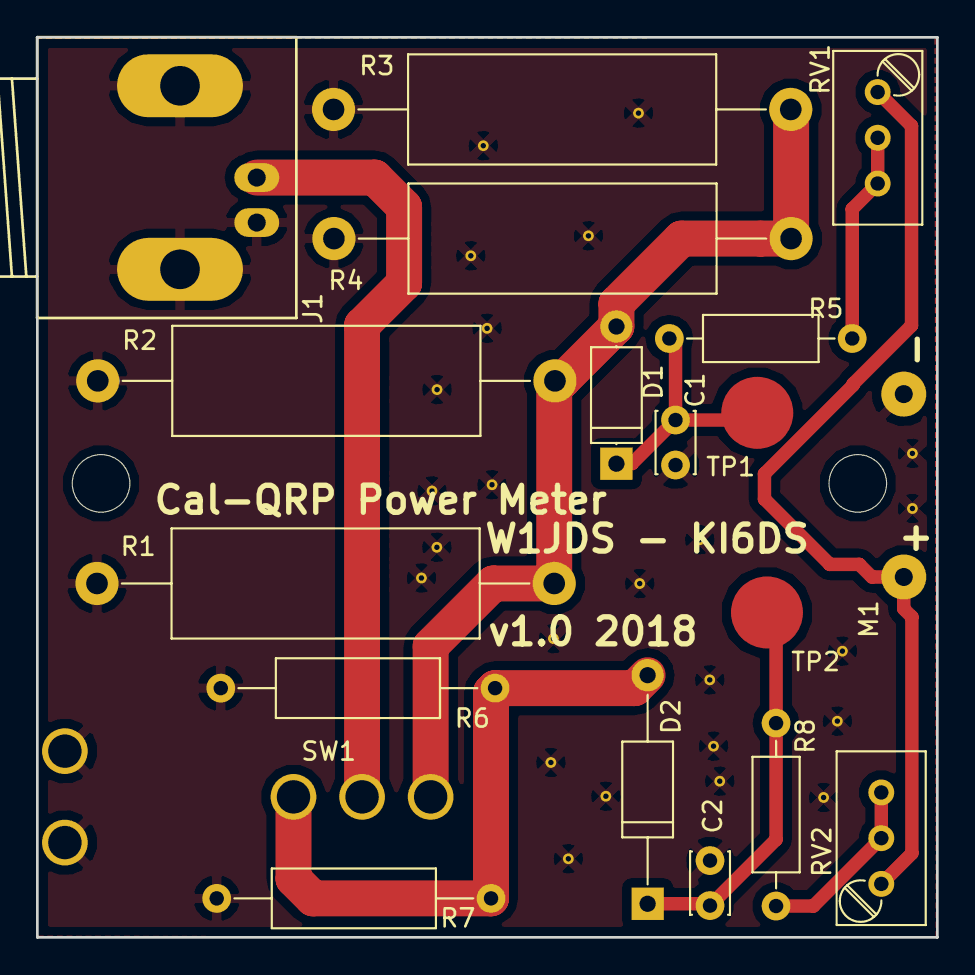
[picture p84: board Analog Power Meter.kicad_pcb from above]

Board: 2 copper layers, 50.0 x 50.0 mm, 19 parts (0 on the bottom side), 9 nets.
