JohnDSutter/Analog-Power-Meter-Rev-1/pics/20180802_153703.jpg

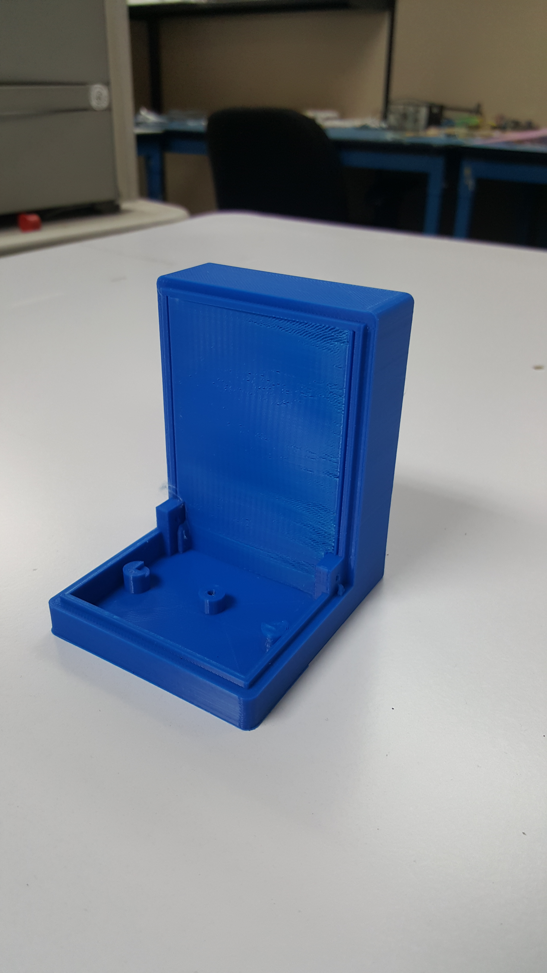
pics/20180802_153703.jpg
