JohnDSutter/Analog-Power-Meter-Rev-1/pics/New folder/20180703_053705.jpg

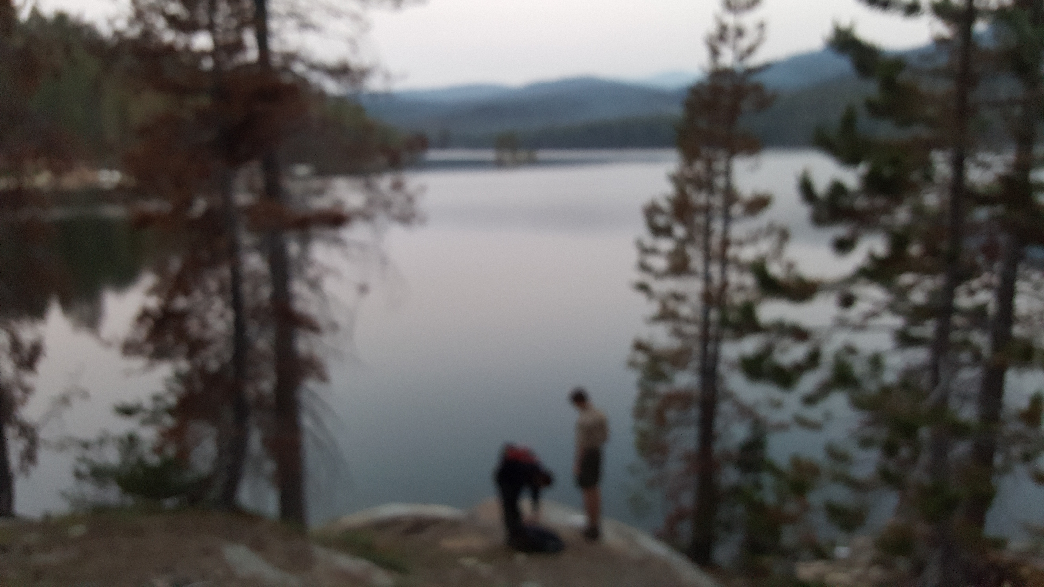
pics/New folder/20180703_053705.jpg
